YC-Vertex/Tars-hdproj/Brief.md

TARS是一款可爱的智能家居终端机器人，其灵感来源于科幻电影Intersteller中的智能机器人。前者继承了后者的炫酷外形与行走方式，极富科技感，深受同学们的喜爱。

它将能够完成家居环境中的电器系统管理，并提供远程遥控、语音控制的双重支持，为我们的生活带来久违的科技感与极大的便利。

未来我们还将继续开发，通过设计配套的可控插头等配件，扩展其可控电器的范围与控制精度，使它成为一款更优秀的终端。
