YC-Vertex/Tars-hdproj/TarsCode/tAirConditioner.cpp

#include "tAirConditioner.h"

IRsend irsend;
AcStatus curStats;

const bool act[13][212] = {
    {0,1,0,1,0,0,0,0,0,0,0,0,0,1,0,1,0,1,0,1,0,1,0,0,0,0,0,1,0,1,0,0,0,0,0,0,0,0,0,0,0,0,0,0,0,0,0,0,0,0,0,0,0,0,0,0,0,0,0,0,0,0,0,0,0,0,0,0,0,0,0,0,0,0,0,1,0,0,0,1,0,0,0,0,0,0,0,0,0,0,0,0,0,0,0,0,0,0,0,0,0,0,0,0,0,0,0,1,0,0,0,0,0,0,0,0,0,0,0,0,0,0,0,0,0,0,0,0,0,0,0,0,0,0,0,0,0,0,0,0,0,0,0,0,0,0,0,0,0,0,0,0,0,0,0,1,0,0,0,0,0,0,0,0,0,0,0,0,0,0,0,0,0,0,0,0,0,1,0,0,0,0,0,0,0,0,0,0,0,0,0,0,0,1,0,1,0,0,0,1,0,0,0,0,0,0,0,0,0},
    {0,1,0,1,0,0,0,0,0,0,0,0,0,1,0,1,0,1,0,1,0,1,0,1,0,0,0,1,0,1,0,0,0,0,0,0,0,0,0,0,0,0,0,0,0,0,0,0,0,0,0,0,0,0,0,0,0,0,0,0,0,0,0,0,0,0,0,0,0,0,0,0,0,0,0,1,0,0,0,1,0,0,0,0,0,0,0,0,0,0,0,0,0,0,0,0,0,0,0,0,0,0,0,0,0,0,0,1,0,0,0,0,0,0,0,0,0,0,0,0,0,0,0,0,0,0,0,0,0,0,0,0,0,0,0,0,0,0,0,0,0,0,0,0,0,0,0,0,0,0,0,0,0,0,0,1,0,0,0,0,0,0,0,0,0,0,0,0,0,0,0,0,0,0,0,0,0,0,0,0,0,0,0,0,0,0,0,0,0,0,0,0,0,0,0,1,0,0,0,0,0,1,0,0,0,0,0,0,0},
    {0,1,0,1,0,0,0,0,0,0,0,0,0,1,0,1,0,1,0,1,0,1,0,0,0,1,0,1,0,1,0,0,0,0,0,0,0,0,0,0,0,0,0,0,0,0,0,0,0,0,0,0,0,0,0,0,0,0,0,0,0,0,0,0,0,0,0,0,0,0,0,0,0,0,0,1,0,0,0,1,0,0,0,0,0,0,0,0,0,0,0,0,0,0,0,0,0,0,0,0,0,0,0,0,0,0,0,1,0,0,0,0,0,0,0,0,0,0,0,0,0,0,0,0,0,0,0,0,0,0,0,0,0,0,0,0,0,0,0,0,0,0,0,0,0,0,0,0,0,0,0,0,0,0,0,1,0,0,0,0,0,0,0,0,0,0,0,0,0,0,0,0,0,0,0,0,0,0,0,0,0,0,0,0,0,0,0,0,0,0,0,0,0,0,0,1,0,0,0,1,0,1,0,0,0,0,0,0,0},
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
};

bool tAcOn(int temperature) {
    int info[212];
    info[0] = 9000; info[1] = 4500; info[211] = 30000;
    for (int i = 2; i < 211; i++) {
        info[i] = act[11][i-2] ? 1500 : 500;
    }

    for (int i = 0; i < AC_REP_COUNT; ++i) {
        irsend.sendRaw(info, 212, 38);
        delay(AC_REP_DELAY);
    }

    if (temperature != AC_DEFAULT_TEMP) {
        tAcTemperature(temperature);
    }
    
    return true;
}

bool tAcOff() {
    int info[212];
    info[0] = 9000; info[1] = 4500; info[211] = 30000;
    for (int i = 2; i < 211; i++) {
        info[i] = act[12][i-2] ? 1500 : 500;
    }
    
    for (int i = 0; i < AC_REP_COUNT; ++i) {
        irsend.sendRaw(info, 212, 38);
        delay(AC_REP_DELAY);
    }
    return true;
}

bool tAcTemperature(int temperature) {
    if (temperature > 30 || temperature < 20) {
        return false;
    }

    int info[212];
    info[0] = 9000; info[1] = 4500; info[211] = 30000;
    for (int i = 2; i < 211; i++) {
        info[i] = act[temperature-20][i-2] ? 1500 : 500;
    }

    for (int i = 0; i < AC_REP_COUNT; ++i) {
        irsend.sendRaw(info, 212, 38);
        delay(AC_REP_DELAY);
    }
    return true;
}

bool tAcMode(AcMode mode) {
    return false;
}

bool tAcSpeed(AcSpeed speed) {
    return false;
}
