YC-Vertex/Tars-hdproj/(commit log)

2019-08-29 vertex the bug fixer
    [NucleonCode.cpp, tSelf.cpp]
2019-08-29 added ledstrip
